IdPDE/agv-charlotte/README.md

# AGV charlotte
All technical information about charlotte

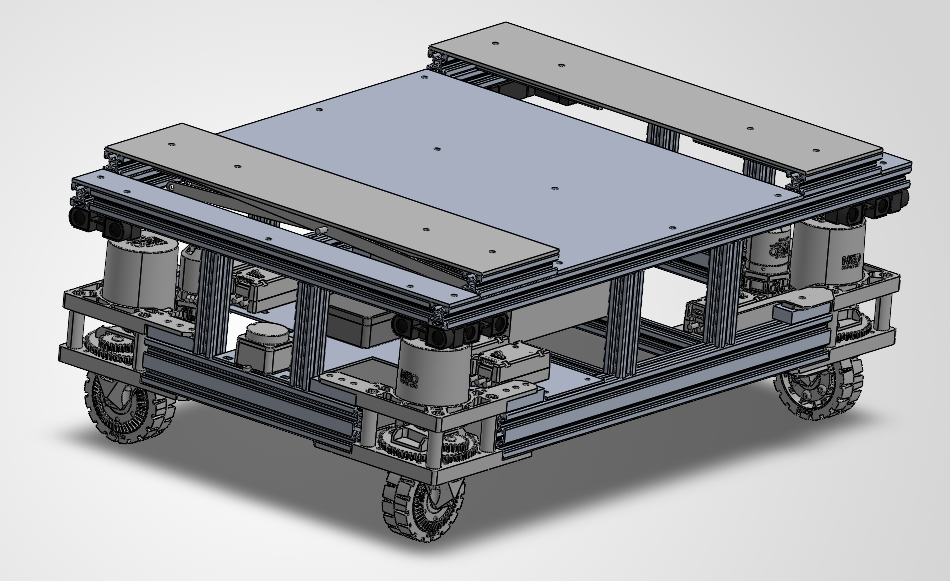
[picture p1: figures/charlotte.png]


## Content
This repository currently includes the following folders
* Documentation
  * REV3MAX swerve module
  * D500 lidar
* SolidWorks
  * Simplified assembly of charlotte
  * D500 lidar

## External links to information
* Swerve module: https://www.revrobotics.com/rev-21-3005/
* Lidar: https://www.waveshare.com/wiki/D500_LiDAR_Kit
*
