IdPDE/agv-charlotte/SolidWorks/lidar.SLDPRT

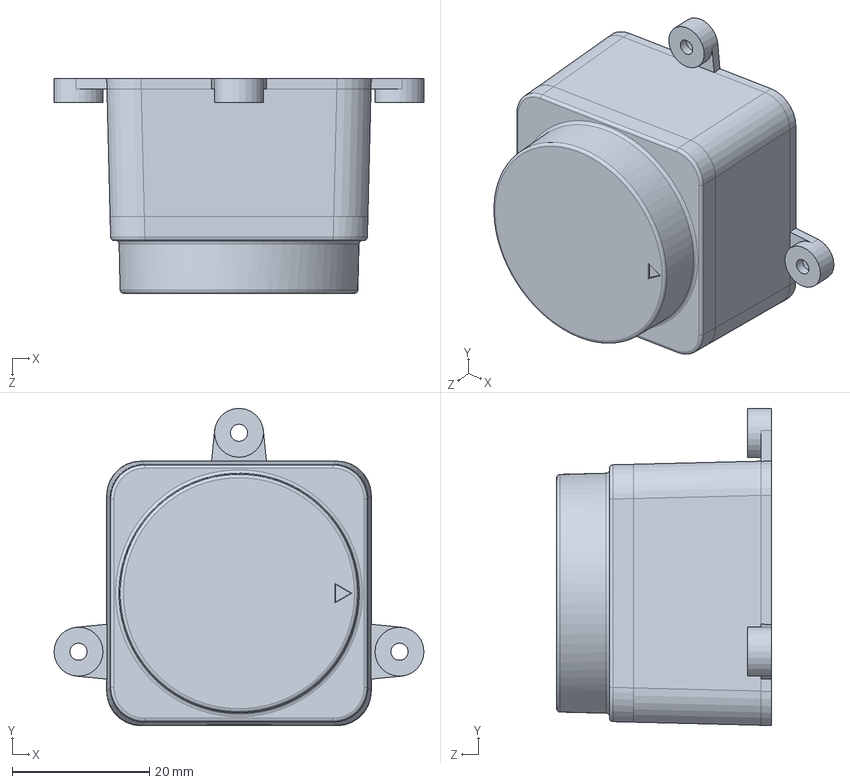
[picture p2: CAD file, 2026-09-02]
SolidWorks/lidar.SLDPRT
54.0 x 46.3 x 31.3 mm
