IdPDE/agv-charlotte/SolidWorks/charlotte-simpified.SLDASM

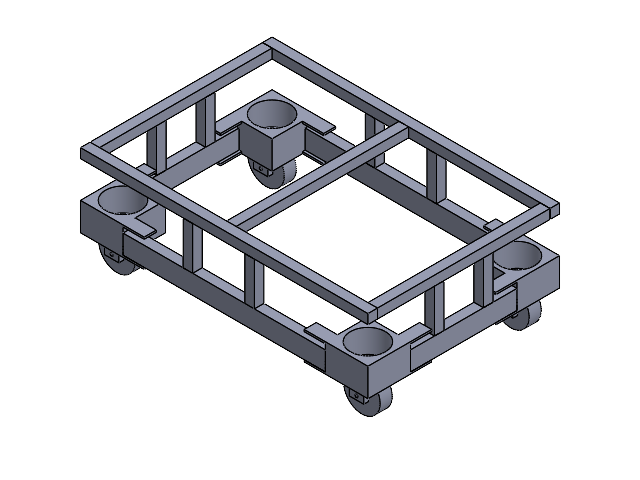
[picture p3: CAD file, 2026-10-12]
SolidWorks/charlotte-simpified.SLDASM
Frame 600-1 x 2
Frame 360-1 x 3
Frame 90-1 x 8
Frame 222-1 x 2
Frame 422-1 x 2
REV basis-1 x 4
REV swivel-1 x 4
REV wheel-1 x 4
